woloszw/swaw-fire-protection-system/Hardware/Slave/SchematicPrintsSlave.PDF

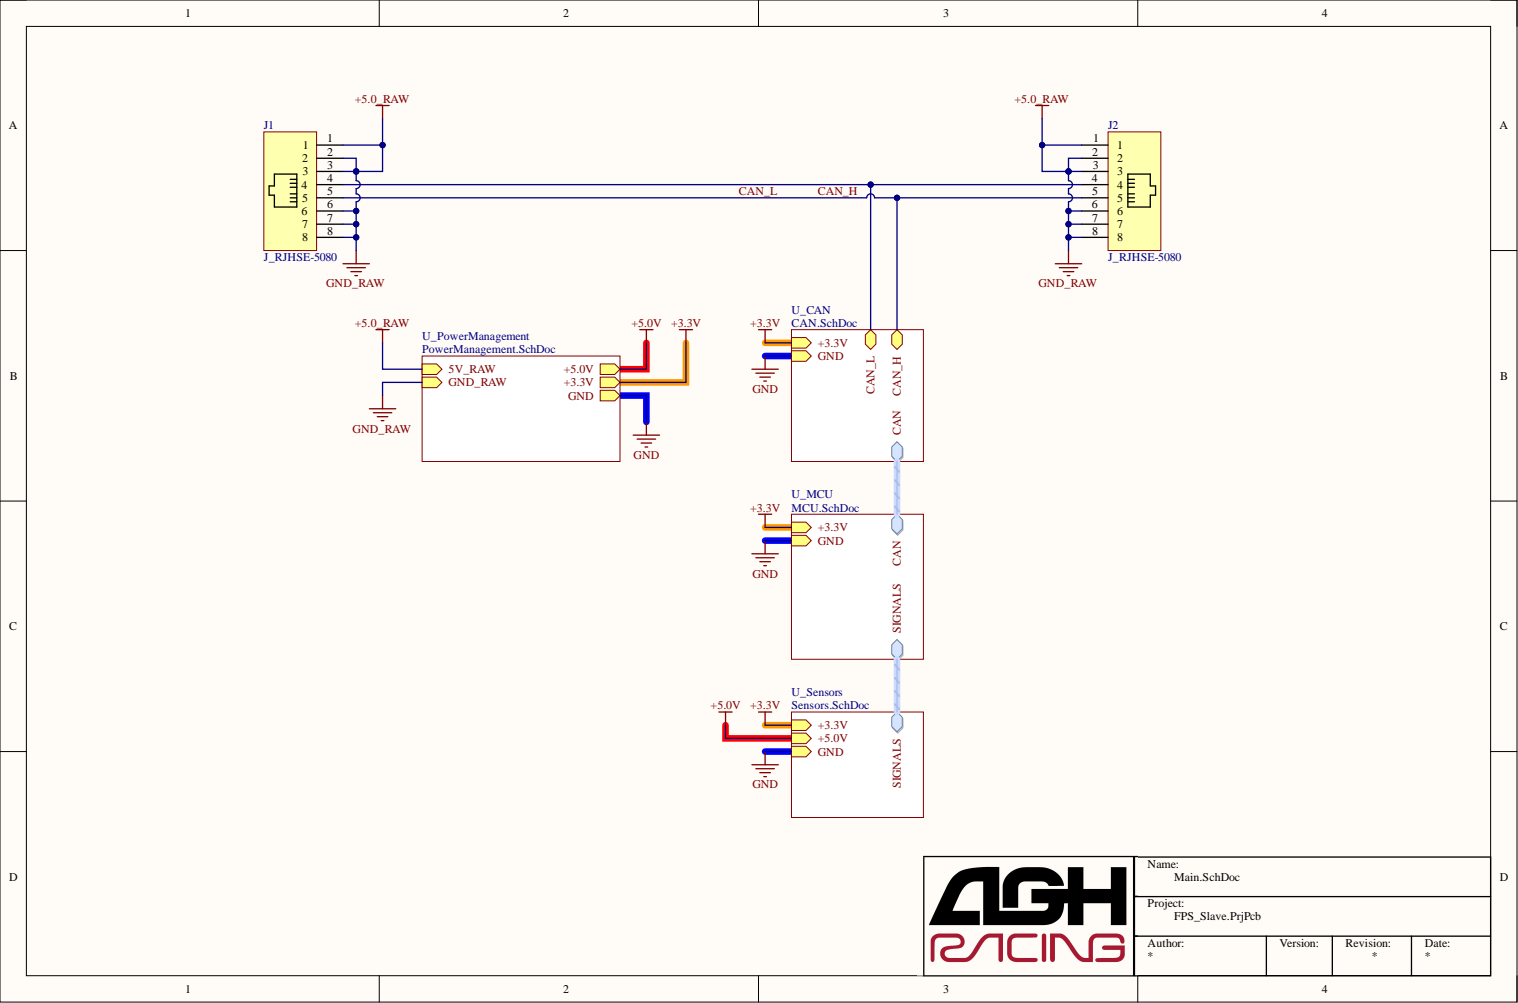
[picture p7: page 1]

CAN_L CAN_H | 5 5

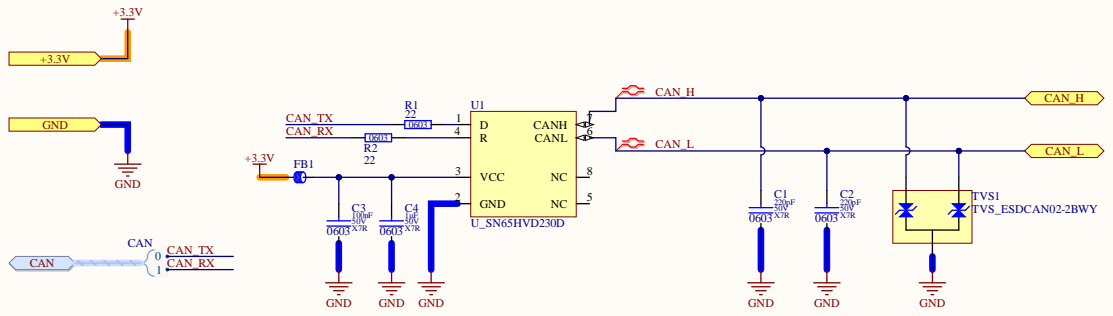
[picture p8: page 2]

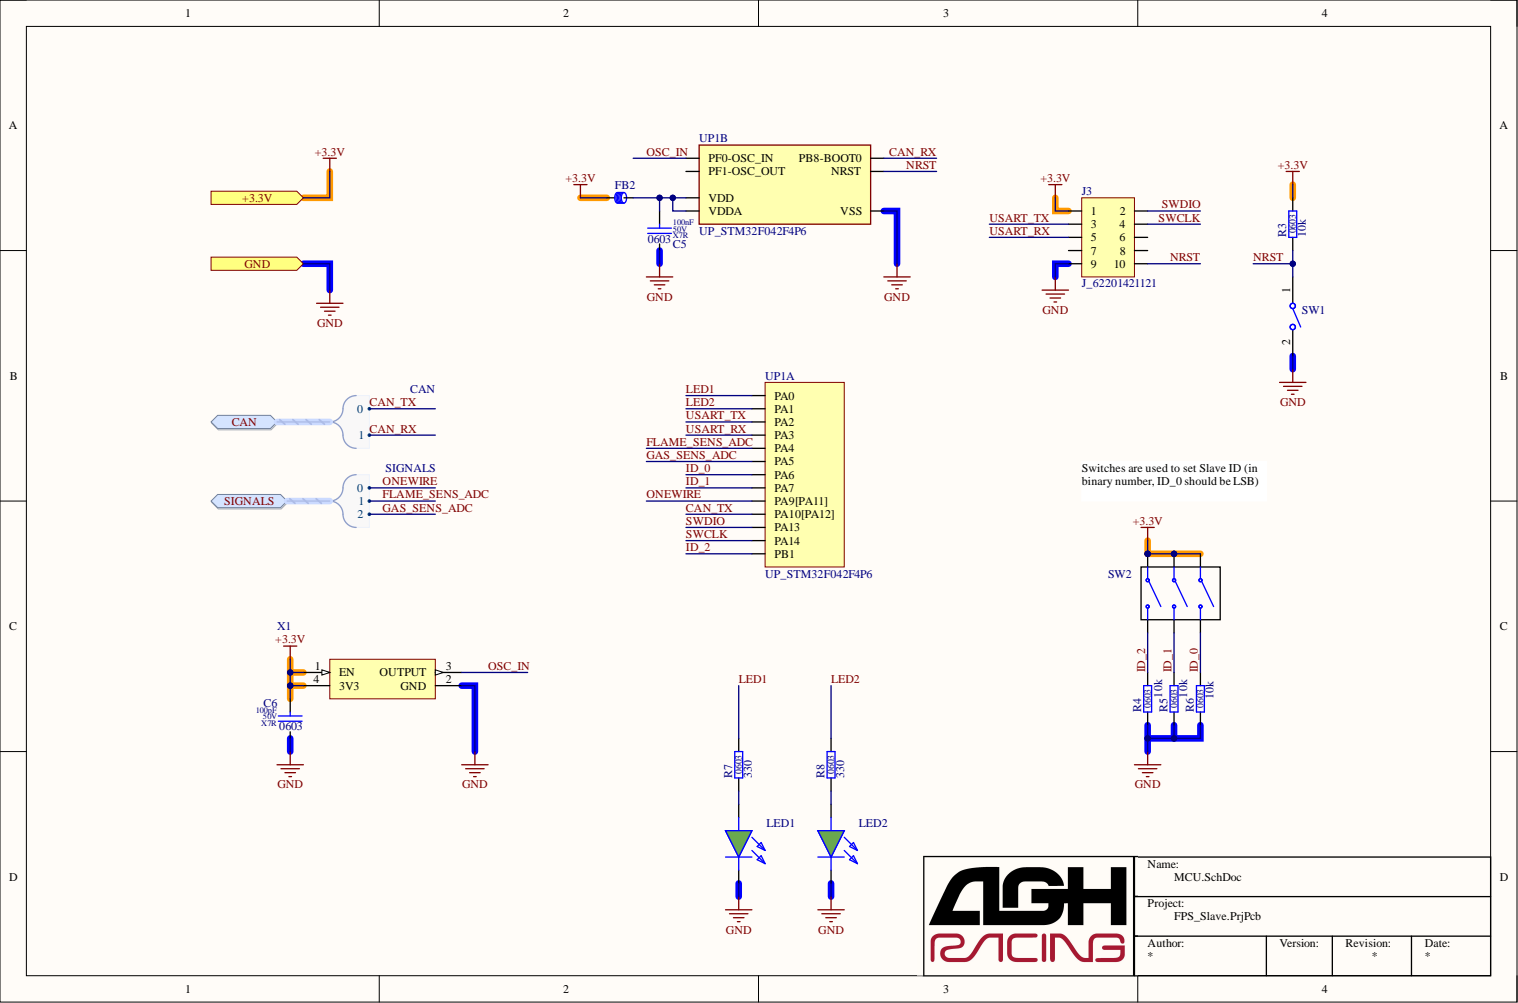
[picture p9: page 3]

Switches are used to set Slave ID (in
binary number, ID_0 should be LSB)

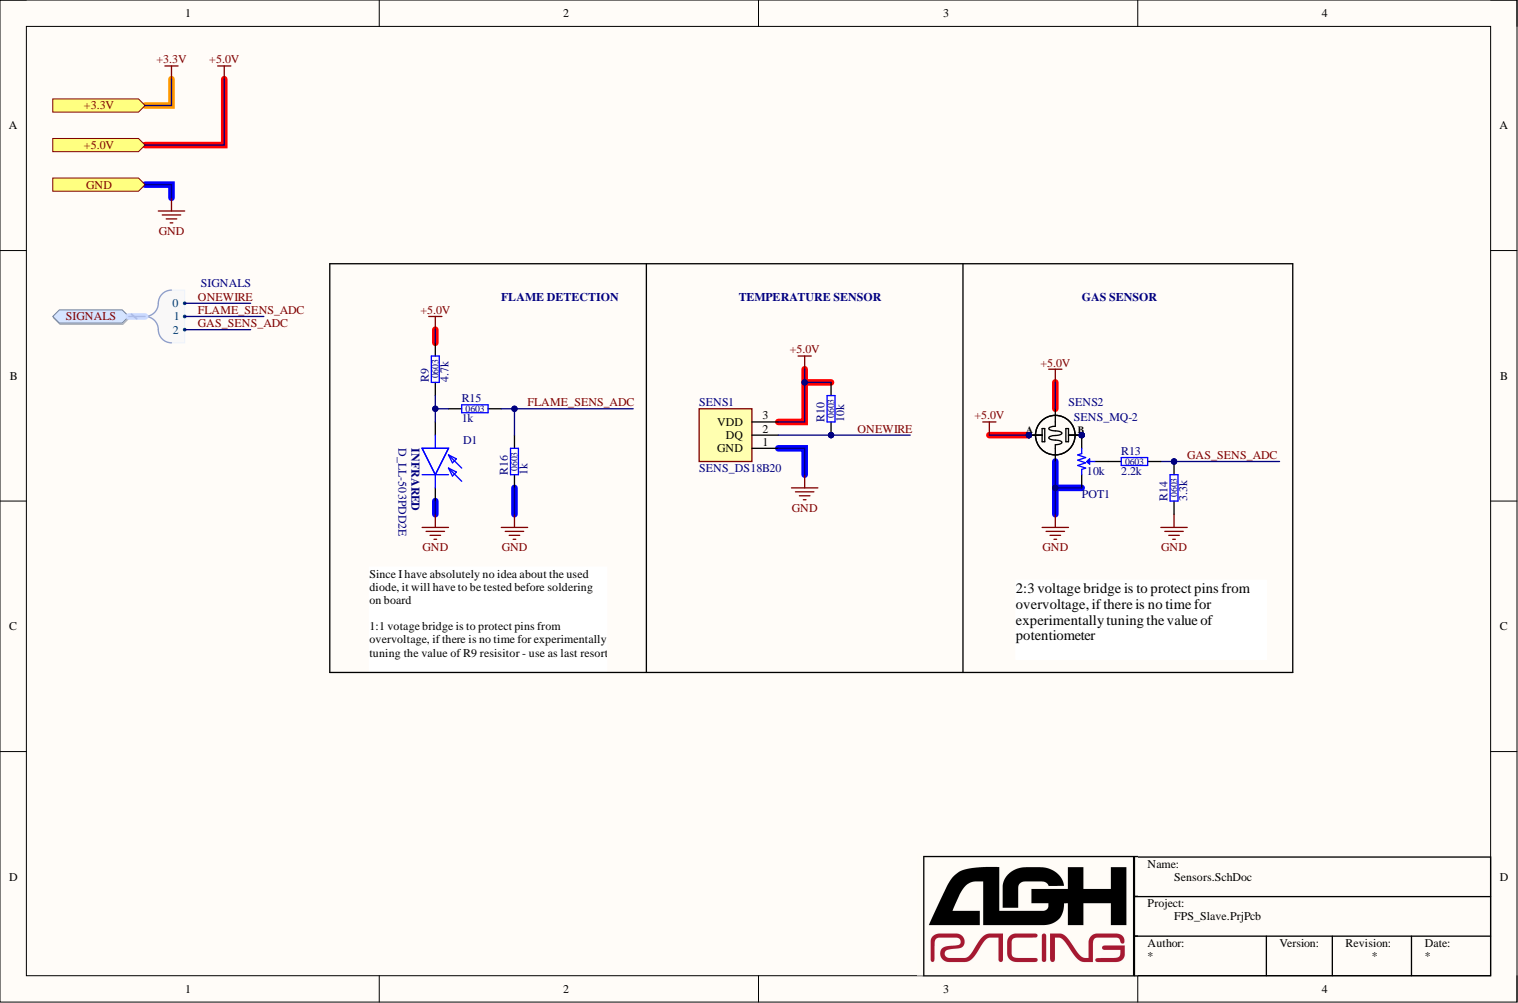
[picture p10: page 4]

Since I have absolutely no idea about the used
diode, it will have to be tested before soldering
on board

2:3 voltage bridge is to protect pins from
overvoltage, if there is no time for
experimentally tuning the value of
potentiometer

1:1 votage bridge is to protect pins from
overvoltage, if there is no time for experimentally
tuning the value of R9 resisitor - use as last resort

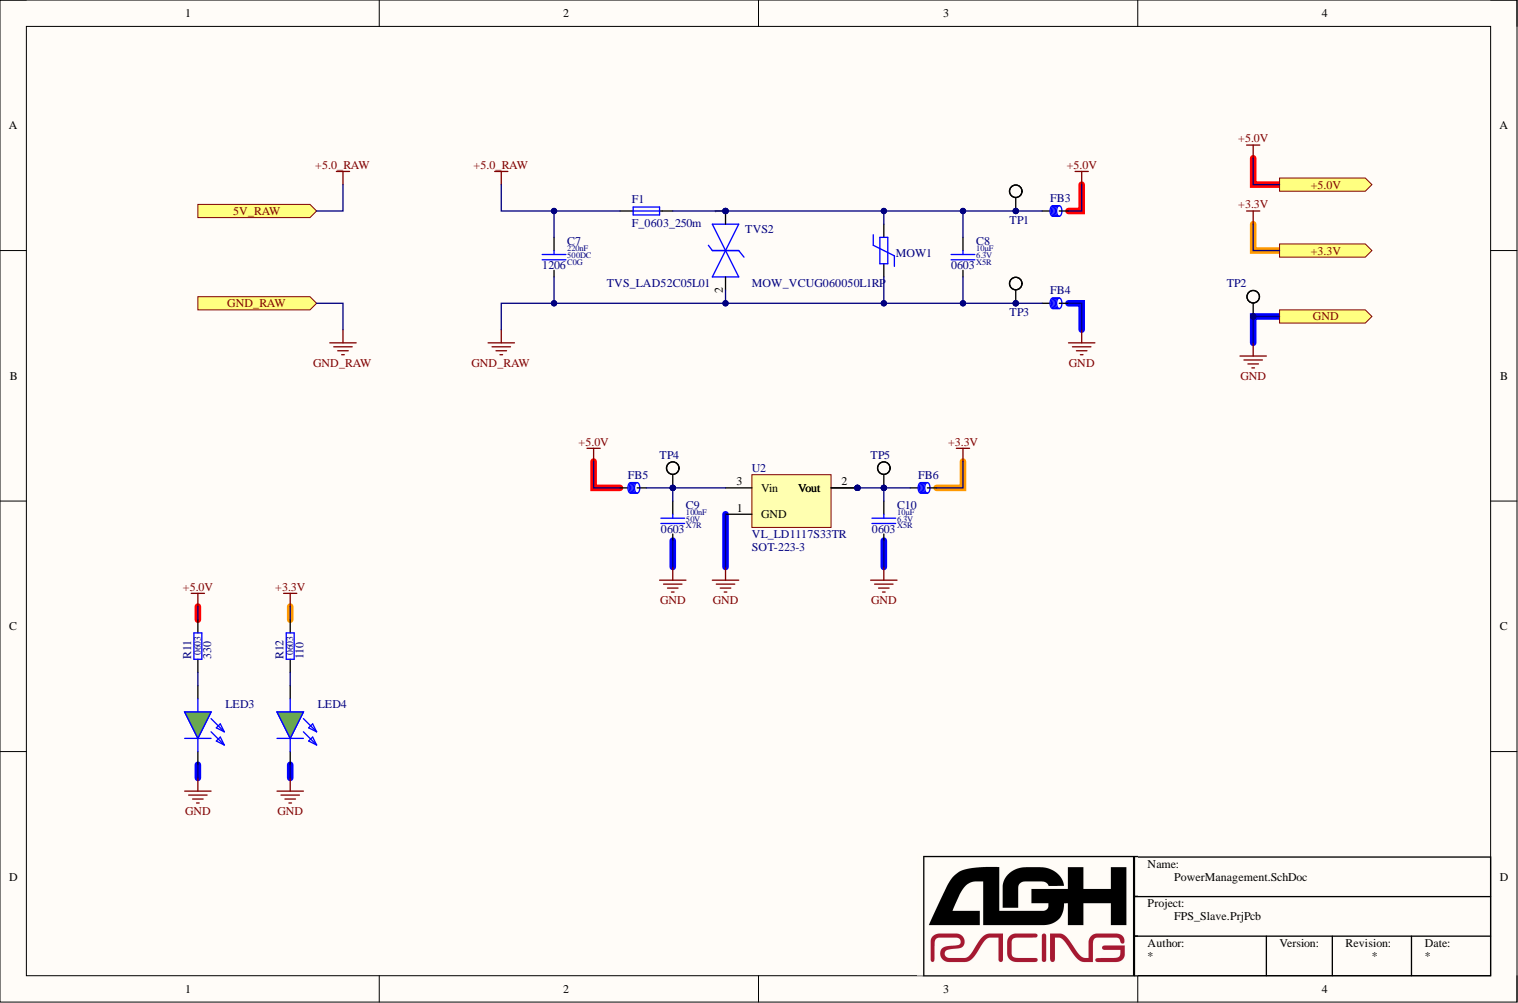
[picture p11: page 5]
