woloszw/swaw-fire-protection-system/Hardware/Master/SchematicPrintsMaster.PDF

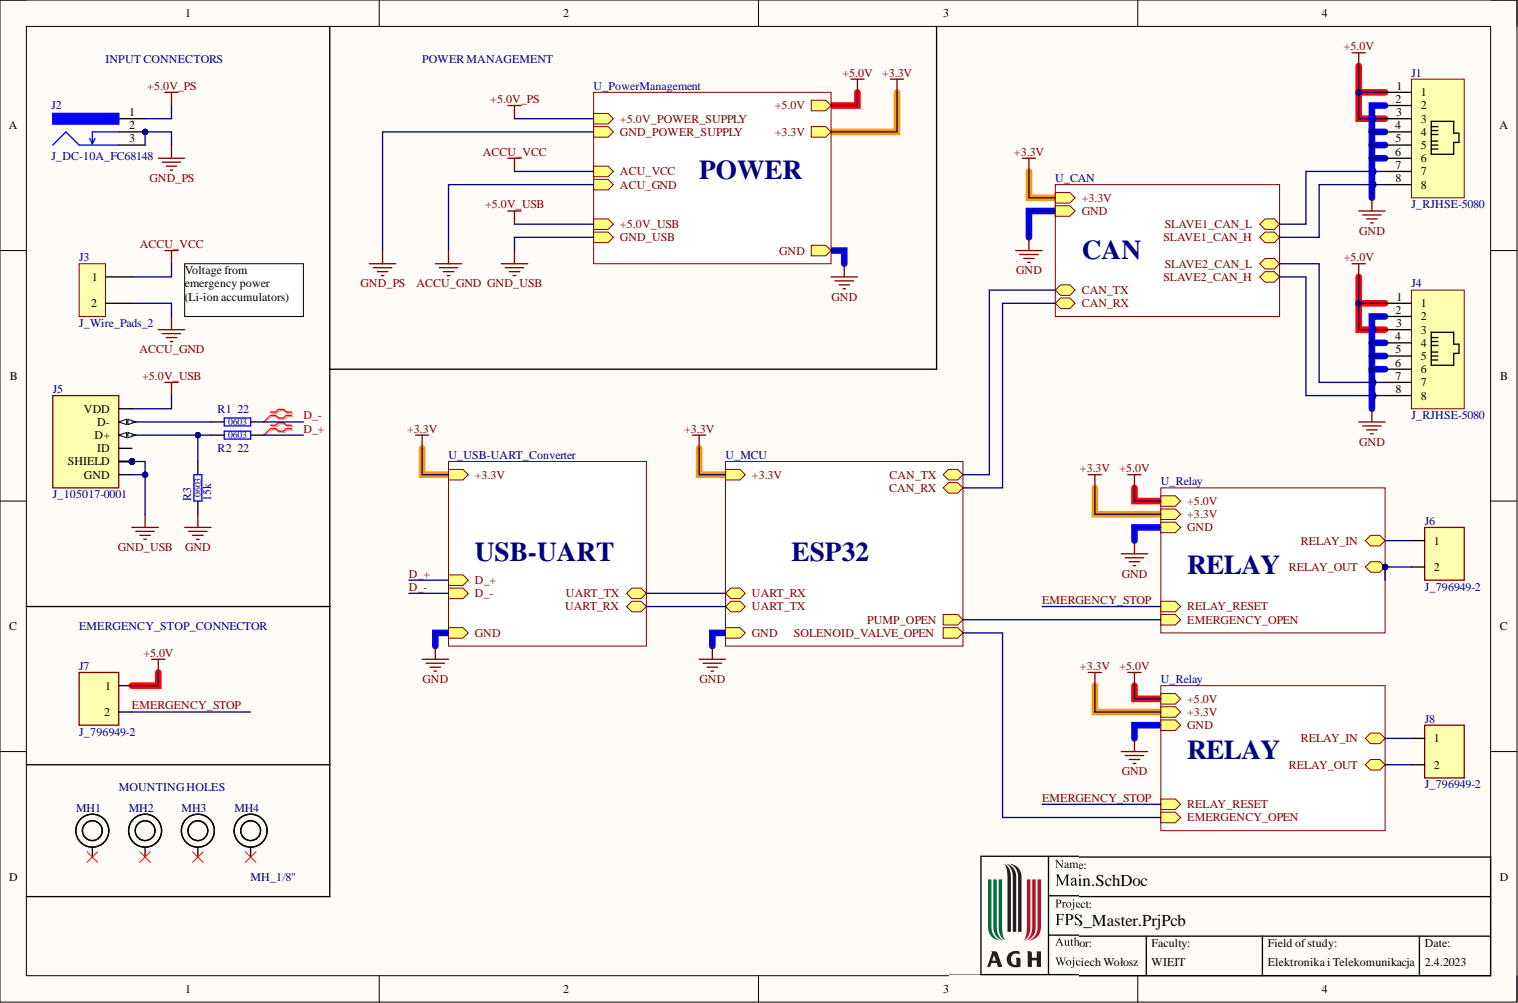
[picture p12: page 1]

12 | Vo l tage from emergency p o w er (L i-i o n accumu lat o r s )

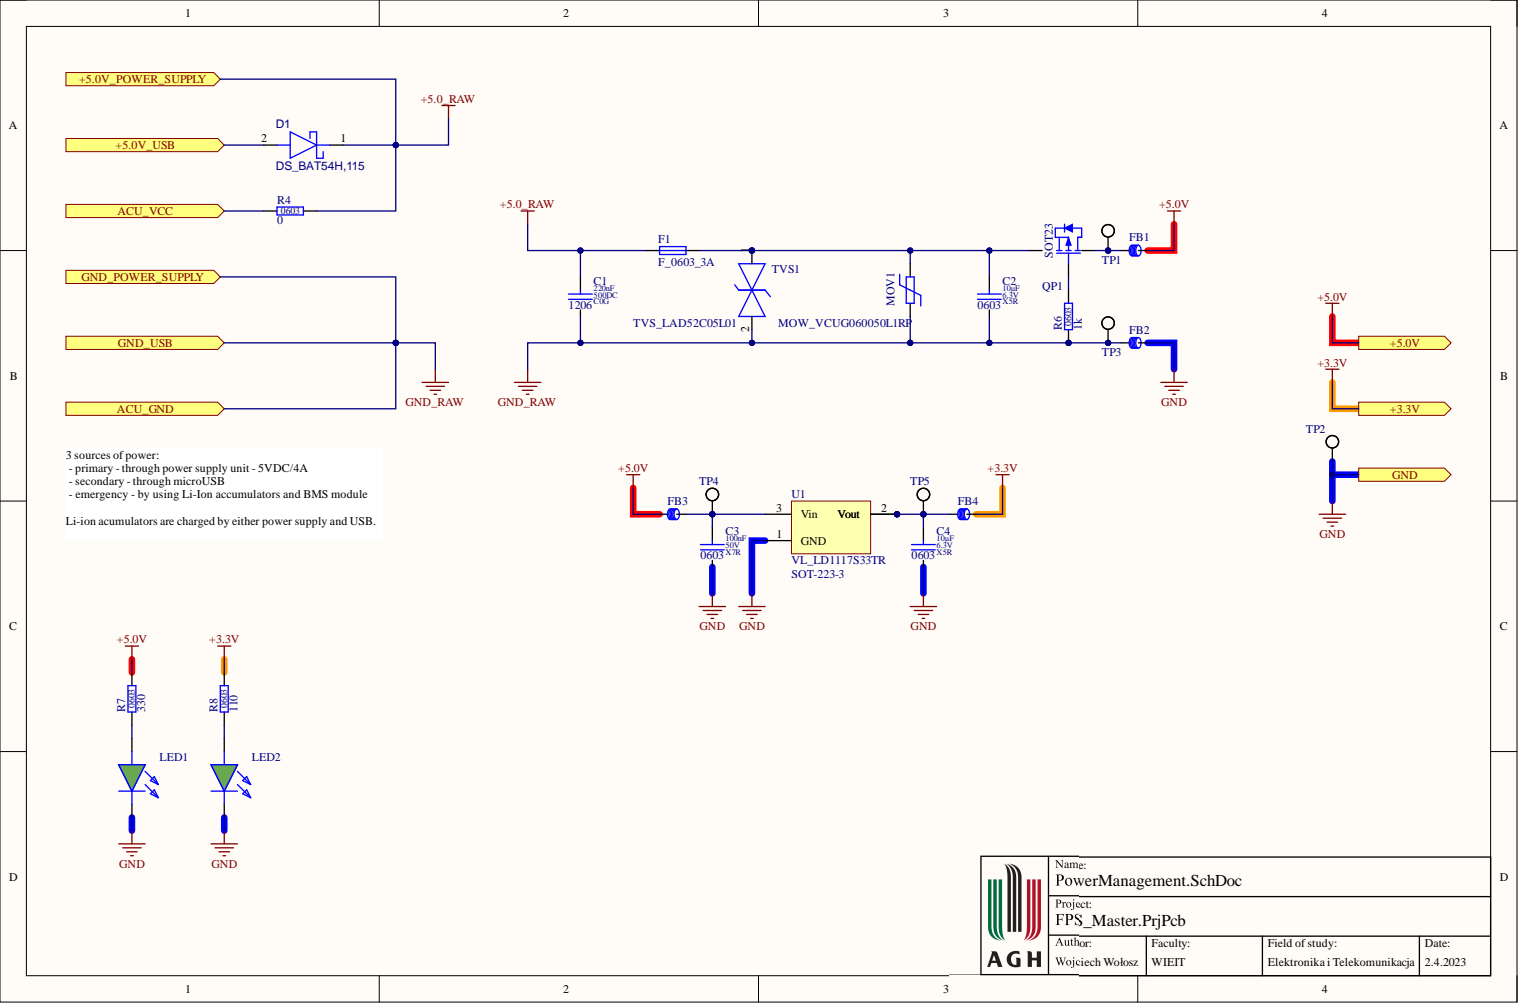
[picture p13: page 2]

3 sources of power:
- primary - through power supply unit - 5VDC/4A
- secondary - through microUSB
- emergency - by using Li-Ion accumulators and BMS module

Li-ion acumulators are charged by either power supply and USB.

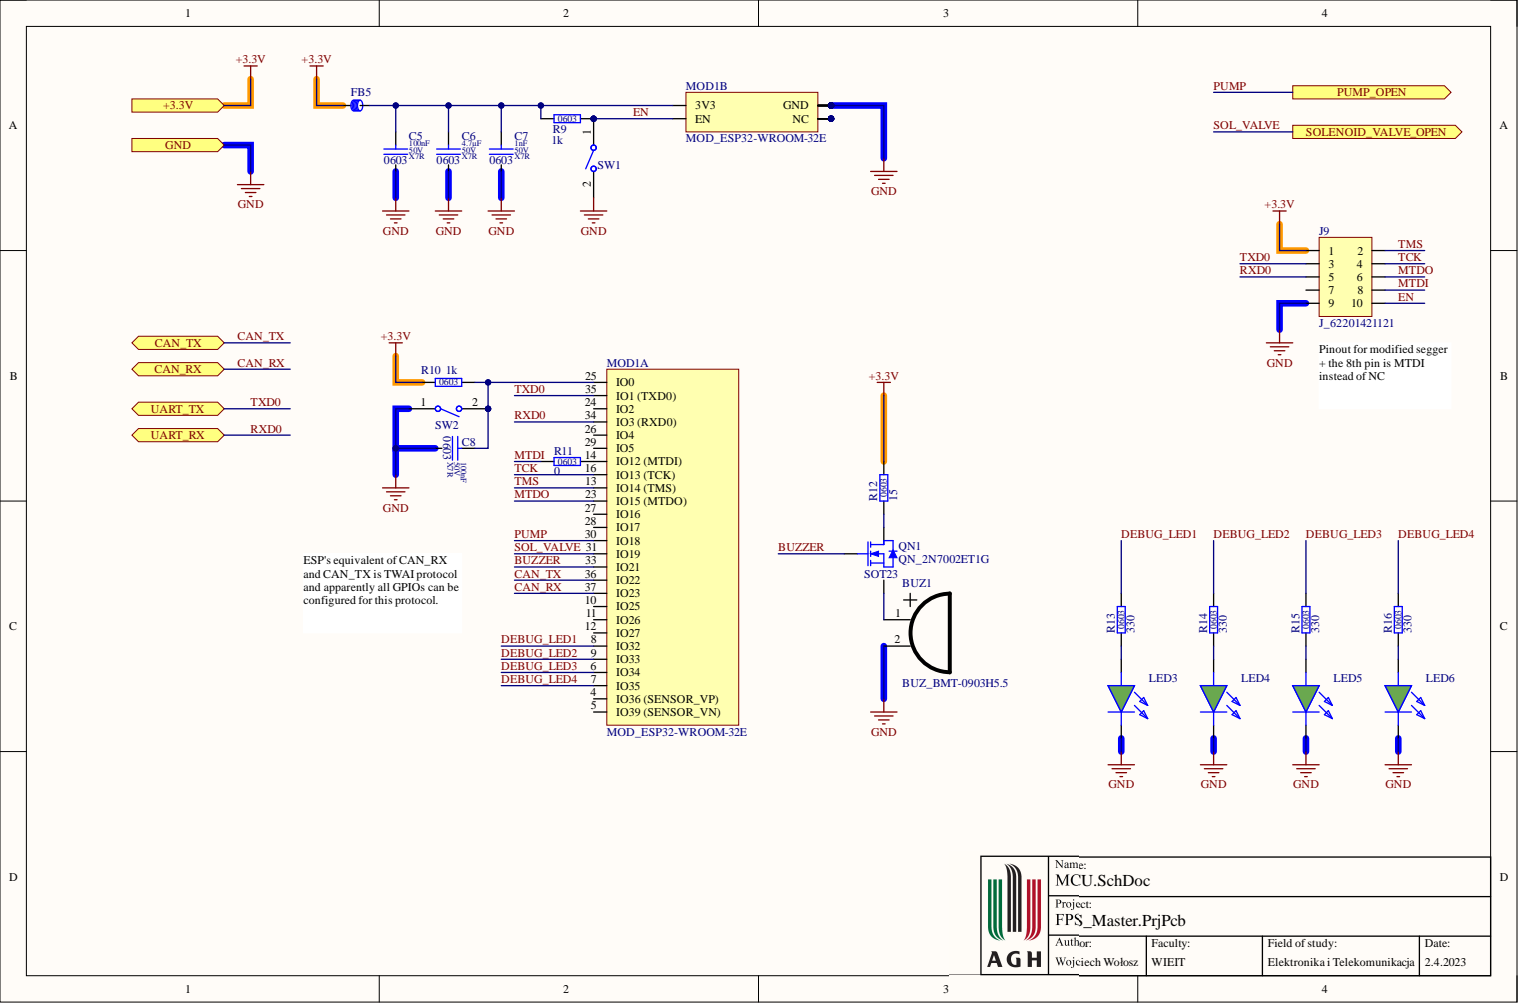
[picture p14: page 3]

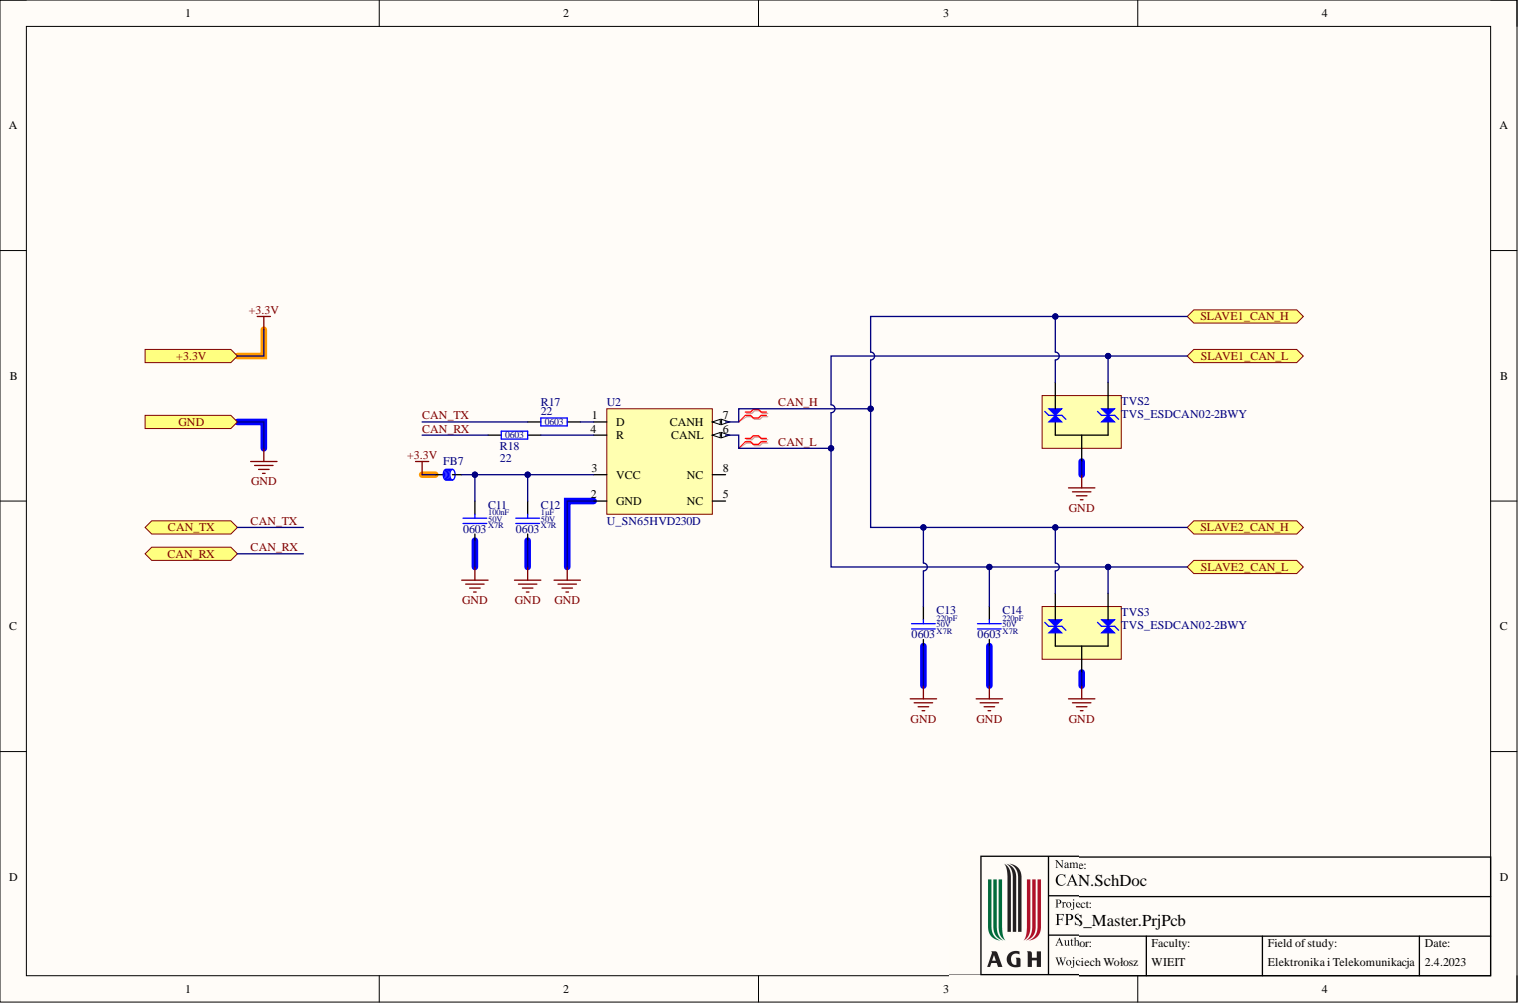
[picture p15: page 4]

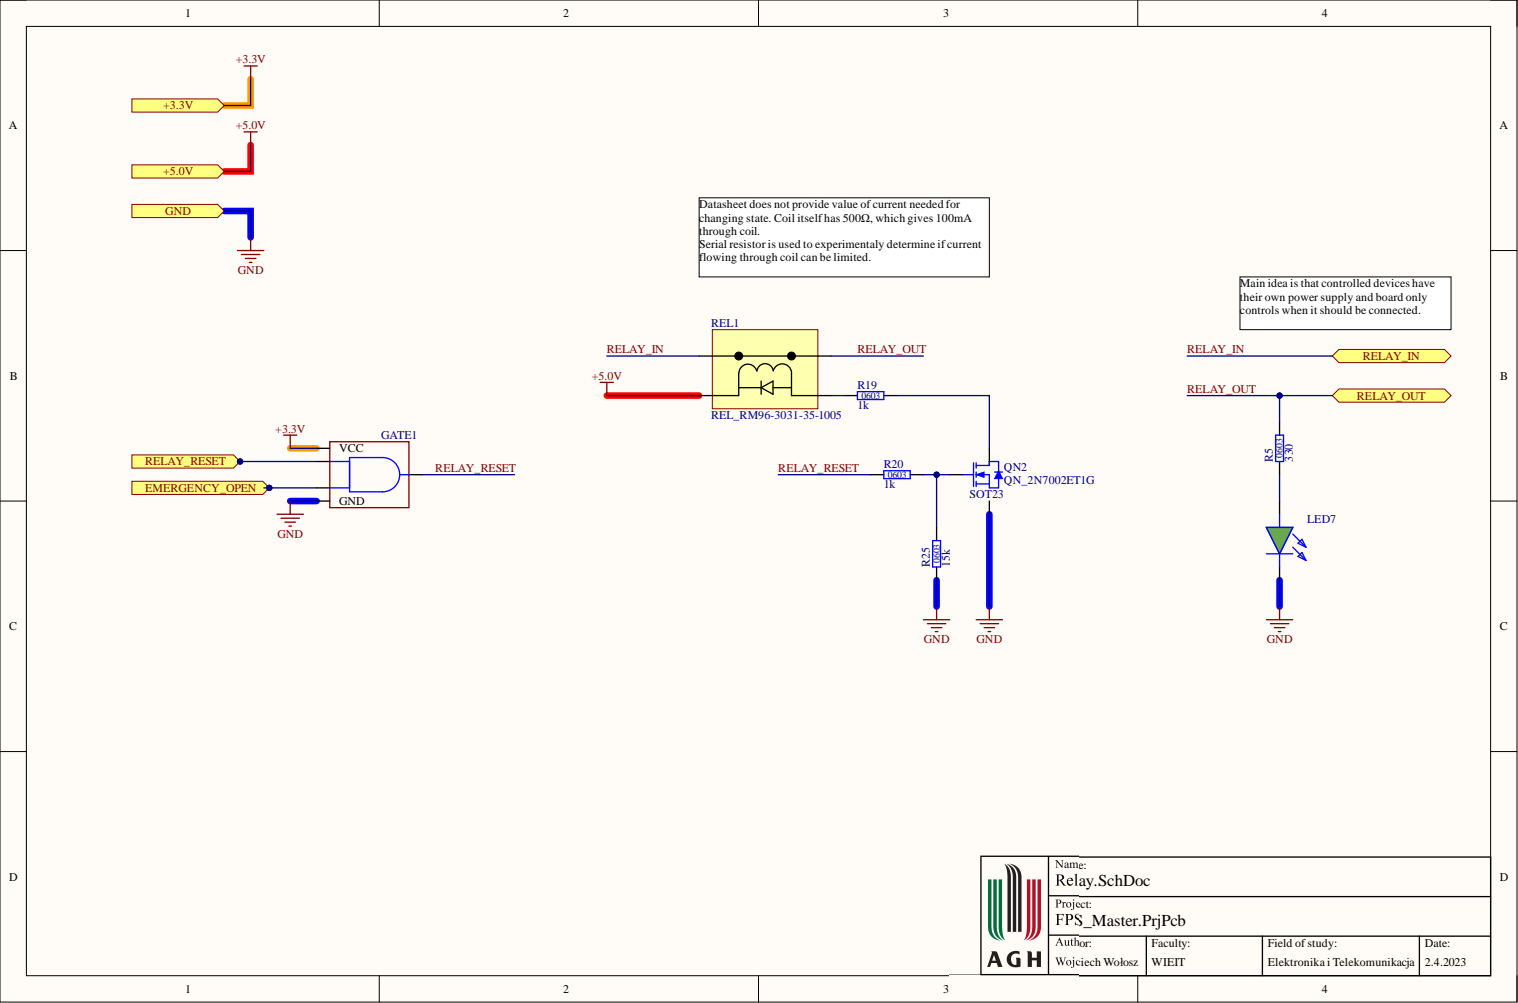
[picture p16: page 5]

Datasheet does not provide value of current needed for
changing state. Coil itself has 500Ω, which gives 100mA
through coil.
Serial resistor is used to experimentaly determine if current
flowing through coil can be limited.

Main idea is that controlled devices have
their own power supply and board only
controls when it should be connected.

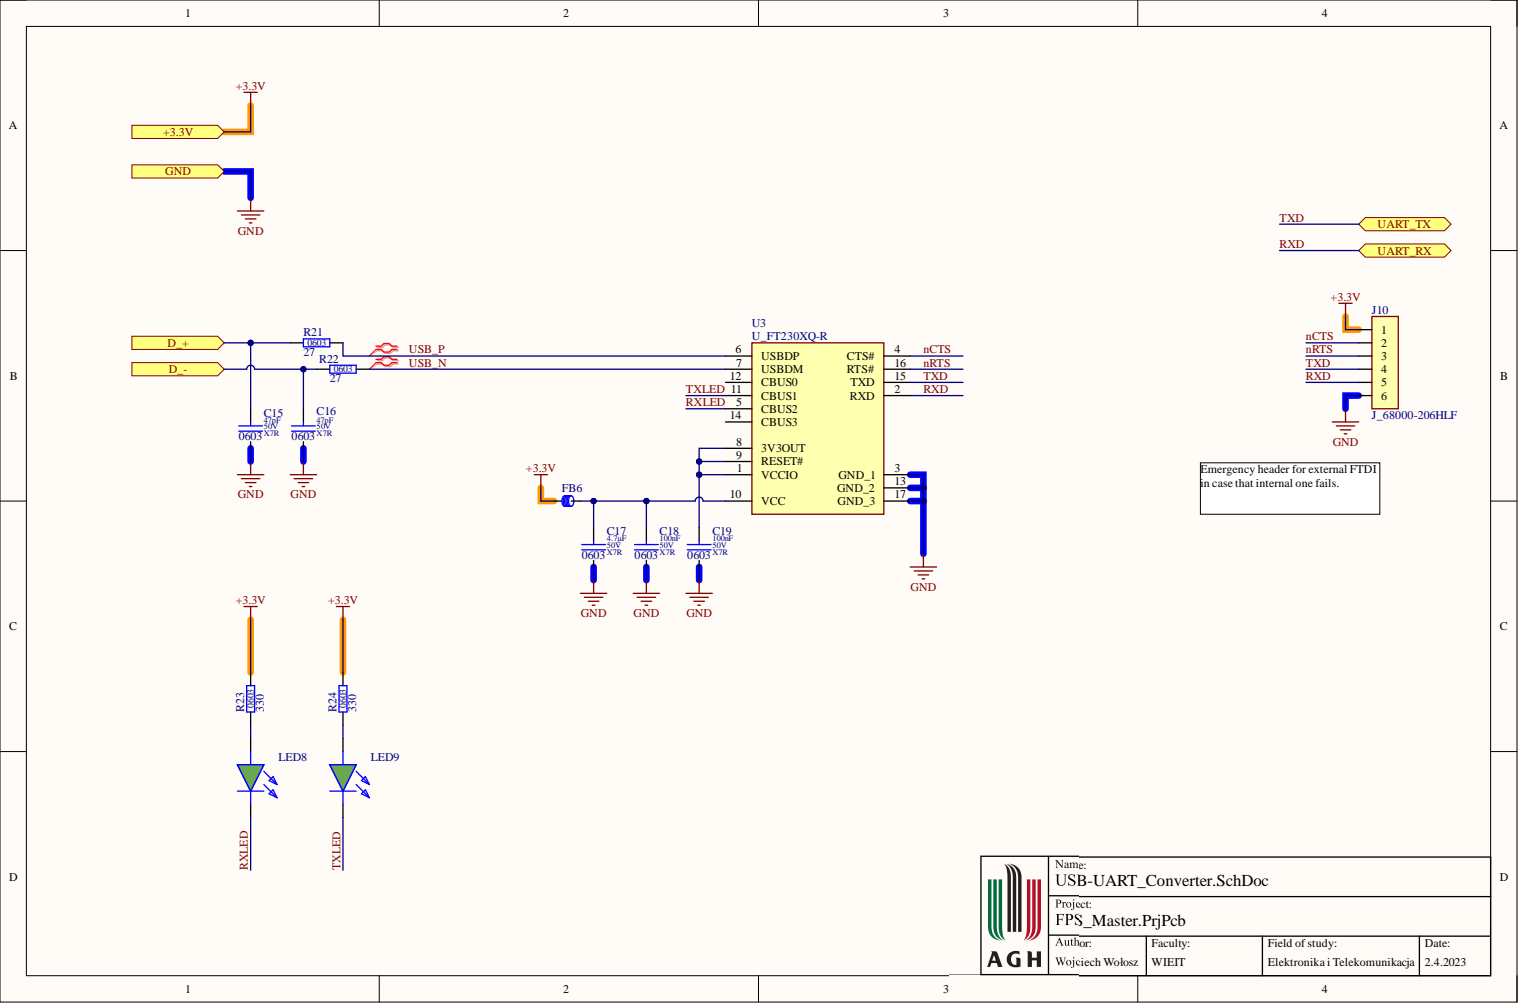
[picture p17: page 6]

0603 | CBUS0 12

Emergency header for external FTDI
in case that internal one fails.
