woloszw/swaw-fire-protection-system/(list of files, drawings)

Other design files:
Hardware/Master/FPS_Master/FPS_Master.PrjPcb
Hardware/Master/FPS_Master/Main.SchDoc
