woloszw/swaw-fire-protection-system/Software/Slave/swaw_slave_flame_detector/Core/Src/main.c

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
/* Includes ------------------------------------------------------------------*/
#include "main.h"
#include "adc.h"
#include "can.h"
#include "tim.h"
#include "usart.h"
#include "gpio.h"

/* USER CODE BEGIN Includes */
#include "ds18b20.h"
#include "flame_sensor.h"
#include "smoke_sensor.h"
#include<string.h>
/* USER CODE END Includes */


/* USER CODE BEGIN PV */
	struct Slv_payload{
		uint16_t smoke_val;
		uint16_t flame_val;
		int16_t	 temp_val;

	}payload_slv;
/* USER CODE END PV */

void SystemClock_Config(void);
/**
  * @brief  The application entry point.
  * @retval int
  */
int main(void)
{
  /* USER CODE BEGIN 1 */
	uint8_t slave_id = 0;
  /* USER CODE END 1 */

  /* MCU Configuration--------------------------------------------------------*/

  /* Reset of all peripherals, Initializes the Flash interface and the Systick. */
  HAL_Init();

  /* Configure the system clock */
  SystemClock_Config();

  /* Initialize all configured peripherals */
  MX_GPIO_Init();
  MX_ADC_Init();
  MX_CAN_Init();
  MX_USART2_UART_Init();
  MX_TIM17_Init();
  /* USER CODE BEGIN 2 */

  //init temperature sensor
  if (ds18b20_init() != HAL_OK) {
    Error_Handler();
  }
  uint8_t ds1[DS18B20_ROM_CODE_SIZE];

  if (ds18b20_read_address(ds1) != HAL_OK) {
    Error_Handler();
  }

  HAL_CAN_Start(&hcan);

  //dip switch slave id read
  int tmp_id;
  tmp_id =HAL_GPIO_ReadPin(ID_0_PIN_GPIO_Port, ID_0_PIN_Pin);
  slave_id |= tmp_id;
  tmp_id =HAL_GPIO_ReadPin(ID_1_PIN_GPIO_Port, ID_1_PIN_Pin);
  slave_id |= (tmp_id<<1);
  tmp_id =HAL_GPIO_ReadPin(ID_2_PIN_GPIO_Port, ID_2_PIN_Pin);
  slave_id |= (tmp_id<<2);
  HAL_Delay(1000);


  // struct for can
  CAN_TxHeaderTypeDef txHeader;
  uint32_t              TxMailbox;
  uint32_t can_node_id_base = slave_id << 8;



  uint8_t tx_can_data[6];

  txHeader.StdId = can_node_id_base | 0x1;  // Node ID - LSB == 1 - payload id

  txHeader.ExtId = 0;      // // Standard frame
  txHeader.RTR = CAN_RTR_DATA;  //  trans mode - data
  txHeader.IDE = CAN_ID_STD;    //standart id format
  txHeader.DLC = 6;  // length (in bytes)




  /* USER CODE END 2 */

  /* Infinite loop */
  /* USER CODE BEGIN WHILE */
  while (1)
  {

	  while (1)
	  {
		  //temp measure
		  ds18b20_start_measure(NULL);
		  HAL_Delay(750);
		  payload_slv.temp_val = ds18b20_get_temp(NULL);


		  //flame measure
		  flame_sensor_read(&payload_slv.flame_val);
		  //smoke measure
		  smoke_sensor_read(&payload_slv.smoke_val);
		  //send to master via can
		  memcpy(tx_can_data, &payload_slv, sizeof(payload_slv));

		  if (HAL_CAN_AddTxMessage(&hcan, &txHeader, tx_can_data, &TxMailbox) == HAL_OK) {
			  // Successfully add frame to queue
		  } else {
			  //Error when try add frame to queue
		  }

		  // wait for send
		  if (HAL_CAN_GetTxMailboxesFreeLevel(&hcan) == 3) {
			  // Send box is free, all frames are send
		  }

		  HAL_Delay(1000);

	  }


    /* USER CODE END WHILE */

    /* USER CODE BEGIN 3 */
  }
  /* USER CODE END 3 */
}

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
