woloszw/swaw-fire-protection-system/Software/Slave/swaw_slave_flame_detector/Core/Inc/main.h

#define CAN_RX_PIN_Pin GPIO_PIN_8
#define CAN_RX_PIN_GPIO_Port GPIOB
#define LED1_Pin GPIO_PIN_0
#define LED1_GPIO_Port GPIOA
#define LED2_Pin GPIO_PIN_1
#define LED2_GPIO_Port GPIOA
#define FLAME_SENS_ADC_PIN_Pin GPIO_PIN_4
#define FLAME_SENS_ADC_PIN_GPIO_Port GPIOA
#define GAS_SENS_ADC_PIN_Pin GPIO_PIN_5
#define GAS_SENS_ADC_PIN_GPIO_Port GPIOA
#define ID_0_PIN_Pin GPIO_PIN_6
#define ID_0_PIN_GPIO_Port GPIOA
#define ID_1_PIN_Pin GPIO_PIN_7
#define ID_1_PIN_GPIO_Port GPIOA
#define ID_2_PIN_Pin GPIO_PIN_1
#define ID_2_PIN_GPIO_Port GPIOB
#define ONE_WIRE_Pin GPIO_PIN_11
#define ONE_WIRE_GPIO_Port GPIOA
#define CAN_TX_PIN_Pin GPIO_PIN_12
#define CAN_TX_PIN_GPIO_Port GPIOA
