woloszw/swaw-fire-protection-system/Software/Slave/swaw_slave_flame_detector/Core/Src/flame_sensor.c

#include "adc.h"

#define NUM_OF_AVERAGE_SAMPL 10

HAL_StatusTypeDef flame_sensor_read(uint16_t* flame_ptr){
	  ADC_ChannelConfTypeDef sConfig_4 = {0};
	  uint32_t avr_value = 0;
	  uint16_t adcValue= 0;
	  /** Configure for the selected ADC regular channel its corresponding rank in the sequencer and its sample time.
	  */
	  sConfig_4.Channel = ADC_CHANNEL_4;
	  sConfig_4.Rank = 1;
	  sConfig_4.SamplingTime = ADC_SAMPLETIME_28CYCLES_5;
	  if (HAL_ADC_ConfigChannel(&hadc, &sConfig_4) != HAL_OK)
	  {
		Error_Handler();
	  }
	  HAL_ADC_Start(&hadc);
	  HAL_ADC_PollForConversion(&hadc, HAL_MAX_DELAY);
	  while(HAL_ADC_GetState(&hadc)== HAL_ADC_STATE_BUSY){}
	  for(int i=0; i<NUM_OF_AVERAGE_SAMPL;i++){
	  		  avr_value += (uint32_t)HAL_ADC_GetValue(&hadc);
	  	  }
	  HAL_ADC_Stop(&hadc);

	  sConfig_4.Rank = ADC_RANK_NONE;
	  if (HAL_ADC_ConfigChannel(&hadc, &sConfig_4) != HAL_OK)
	  {
		Error_Handler();
	  }
	  avr_value = avr_value/NUM_OF_AVERAGE_SAMPL;

	  adcValue = avr_value;

	  *flame_ptr = adcValue;

	  return HAL_OK;

}
