woloszw/swaw-fire-protection-system/Software/Slave/swaw_slave_flame_detector/Core/Src/wire.c

#include "wire.h"
#include "gpio.h"
#include "tim.h"

HAL_StatusTypeDef wire_init(void)
{
  return HAL_TIM_Base_Start(&htim17);
}

static void delay_us(uint32_t us)
{
  __HAL_TIM_SET_COUNTER(&htim17, 0);

  while (__HAL_TIM_GET_COUNTER(&htim17) < us) {}
}

HAL_StatusTypeDef wire_reset(void)
{
  int rc;

  HAL_GPIO_WritePin(ONE_WIRE_GPIO_Port, ONE_WIRE_Pin, GPIO_PIN_RESET);
  delay_us(480);
  HAL_GPIO_WritePin(ONE_WIRE_GPIO_Port, ONE_WIRE_Pin, GPIO_PIN_SET);
  delay_us(70);
  rc = HAL_GPIO_ReadPin(ONE_WIRE_GPIO_Port, ONE_WIRE_Pin);
  delay_us(410);

  if (rc == 0)
    return HAL_OK;
  else
    return HAL_ERROR;
}

static int read_bit(void)
{
  int rc;
  HAL_GPIO_WritePin(ONE_WIRE_GPIO_Port, ONE_WIRE_Pin, GPIO_PIN_RESET);
  delay_us(6);
  HAL_GPIO_WritePin(ONE_WIRE_GPIO_Port, ONE_WIRE_Pin, GPIO_PIN_SET);
  delay_us(9);
  rc = HAL_GPIO_ReadPin(ONE_WIRE_GPIO_Port, ONE_WIRE_Pin);
  delay_us(55);
  return rc;
}

uint8_t wire_read(void)
{
  uint8_t value = 0;
  int i;
  for (i = 0; i < 8; i++) {
    value >>= 1;
    if (read_bit())
      value |= 0x80;
  }
  return value;
}

static void write_bit(int value)
{
  if (value) {
    HAL_GPIO_WritePin(ONE_WIRE_GPIO_Port, ONE_WIRE_Pin, GPIO_PIN_RESET);
    delay_us(6);
    HAL_GPIO_WritePin(ONE_WIRE_GPIO_Port, ONE_WIRE_Pin, GPIO_PIN_SET);
    delay_us(64);
  } else {
    HAL_GPIO_WritePin(ONE_WIRE_GPIO_Port, ONE_WIRE_Pin, GPIO_PIN_RESET);
    delay_us(60);
    HAL_GPIO_WritePin(ONE_WIRE_GPIO_Port, ONE_WIRE_Pin, GPIO_PIN_SET);
    delay_us(10);
  }
}

void wire_write(uint8_t byte)
{
  int i;
  for (i = 0; i < 8; i++) {
    write_bit(byte & 0x01);
    byte >>= 1;
  }
}

static uint8_t byte_crc(uint8_t crc, uint8_t byte)
{
  int i;
  for (i = 0; i < 8; i++) {
    uint8_t b = crc ^ byte;
    crc >>= 1;
    if (b & 0x01)
      crc ^= 0x8c;
    byte >>= 1;
  }
  return crc;
}

uint8_t wire_crc(const uint8_t* data, int len)
{
  int i;
    uint8_t crc = 0;

    for (i = 0; i < len; i++)
      crc = byte_crc(crc, data[i]);

    return crc;
}
