woloszw/swaw-fire-protection-system/(commit log)

2023-03-11 Edided ignore
    [FPS_Master.PrjPcb, Main.SchDoc]
2023-03-13 Added .pptx and .pdf of project assumptions
    [Main.SchDoc]
2023-04-23 Added schematic prints to Hardware
    [FPS_Master.PrjPcb, Main.SchDoc]
2023-04-23 Changed schematic prints.pdf for Slave
2023-04-23 [master] minor changes to web app, added block schematic
2023-06-20 Can bus fix
2023-06-21 Add averaging to sensor data in slave
