woloszw/swaw-fire-protection-system/(notices)

Notices in the files:
Software/Slave/swaw_slave_flame_detector/Core/Src/adc.c:
Copyright (c) 2023 STMicroelectronics.
All rights reserved.
This software is licensed under terms that can be found in the LICENSE file
